ZX-80/PicoVideocart/Firmware/error.h

/** \file error.h
 *  \brief Debug/error related code
 */

#pragma once

namespace BLINK {
    constexpr uint8_t OVERCLOCK_FAILED = 3;
    constexpr uint8_t NO_VALID_FILES = 4;
}

/*! \brief Blink an error code to the LED. Useful for simple debugging
 *
 * \param code The error code
 * \param repeat the amount of times to output the code
 */
void blink_code(uint8_t code, uint8_t repeat=3) {
    gpio_put(LED_BUILTIN, false);
    for (uint8_t j = 0; j < repeat; j++) {
        for (uint8_t i = 0; i < 2 * code; i++) {
            gpio_xor_mask(1ul << LED_BUILTIN);
            sleep_ms(250);
        }
        sleep_ms(1000);
    }
}
