ZX-80/PicoVideocart/(commit log)

2022-03-30 Fix bus contention issue
    Originally we were always outputting data when WRITE goes high. This would cause bus contention, as the CPU could be outputting data at that time. Now we make sure the CPU is expecting data before outputting to the bus on WRITE.
    [PicoVideocart.ino]
2022-03-31 data bus is now read correctly
    A few inline functions and comments were added to make the code clearer. All instructions that read the data bus were moved to execute only after 3 ticks. This is necessary, as the data bus isn't valid until somewhere between 3 - 4 ticks when coming from the CPU.
    [PicoVideocart.ino]
2022-04-03 Downgrade for testing
    This is an older version for a different test board that will slowly be updated to be similar to the main branch. This version makes better use of built in functions/macros.
2022-04-03 Update PicoVideocart.ino
    Execution was moved from tick 1 into the rising edge of WRITE to allow the DBUS value to stabilize. Added address range limit to avoid contention with addresses below 0x800. Any interrupt/port instructions have been stripped and marked as TODO.
    [PicoVideocart.ino]
2022-04-03 Replaced magic numbers with constants
    [PicoVideocart.ino]
2022-06-27 fix sram
    SRAM_START_ADDR & SRAM_SIZE were erroneously removed
    sys_clk.h was replaced with the standard library version
    [PicoVideocart.ino]
2022-09-05 CHF file support
    Support was added for the CHF file format described at: https://github.com/ZX-80/Videocart-Image-Format
    CPU speed was reduced from 428 MHz @ 1.3V to 400 MHz @ 1.3V. This was done, as not all pico units support overclocking to 428 MHz.
    SPI pinouts were modified for the revision 2A PCB.
2022-09-27 Detect SD card eject
    Rescan SD card when it's inserted/ejected
2022-10-13 Refactor
    Major refactoring.
    Variables/classes/functions were moved to different files according to their group.
    Documentation comments were added.
    Core 1 was given high priority to avoid any stalls on memory accesses.
    no_sd_rom was renamed to default_rom.
    [PicoVideocart.ino, gpio.hpp, ports.hpp, romc.hpp]
